IanAber/CurrentSensor/DC Sensor Documentation.odt

DC Measurement Device ModBus Layout

R/W | Register Type | Register Number | Function
W | Holding | 3 | Set Low Voltage Calibration
W | Holding | 4 | Set High Voltage Calibration
W | Multiple Holding | 5-6 | Set Low Current Calibration
W | Multiple Holding | 7-8 | Set High Current Calibration
R | Inputs | 0 | Voltage
R | Inputs | 1 | Current Low Word
R | Inputs | 2 | Current High Word
