IanAber/CurrentSensor/Core/Src/main.c

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
/* Includes ------------------------------------------------------------------*/
#include "main.h"
#include "cmsis_os.h"
#include "can.h"
#include "iwdg.h"
#include "spi.h"
#include "usart.h"
#include "usb.h"
#include "gpio.h"

/* USER CODE BEGIN Includes */
#include "MCP3462.h"
/* USER CODE END Includes */


/* USER CODE BEGIN PV */
modbusHandler_t ModbusH;
ModbusDATA_t ModbusDATA;

/* USER CODE END PV */

void SystemClock_Config(void);
void MX_FREERTOS_Init(void);
/**
  * @brief  The application entry point.
  * @retval int
  */
int main(void)
{
  /* MCU Configuration--------------------------------------------------------*/

  /* Reset of all peripherals, Initializes the Flash interface and the Systick. */
  HAL_Init();

  /* Configure the system clock */
  SystemClock_Config();

  /* Initialize all configured peripherals */
  MX_GPIO_Init();
  MX_CAN_Init();
  MX_SPI1_Init();
  MX_USART1_UART_Init();
  MX_USB_PCD_Init();
  MX_IWDG_Init();
  /* USER CODE BEGIN 2 */

  /* Get the slope and offset parameters from Flash memory */
  LoadCalibrationData();

  /* flash LEDs to show startup */
  for ( int i = 0; i < 5; i++) {
	  HAL_GPIO_WritePin(GREEN_LED_GPIO_Port, GREEN_LED_Pin, GPIO_PIN_SET);
	  HAL_Delay(100);
	  HAL_GPIO_WritePin(RED_LED_GPIO_Port, RED_LED_Pin, GPIO_PIN_SET);
	  HAL_Delay(100);
	  HAL_GPIO_WritePin(GREEN_LED_GPIO_Port, GREEN_LED_Pin, GPIO_PIN_RESET);
	  HAL_Delay(100);
	  HAL_GPIO_WritePin(RED_LED_GPIO_Port, RED_LED_Pin, GPIO_PIN_RESET);
	  HAL_Delay(100);
  }


  /* USER CODE END 2 */

  /* Init scheduler */
  osKernelInitialize();

  /* Call init function for freertos objects (in freertos.c) */
  MX_FREERTOS_Init();

  /* Start scheduler */
  osKernelStart();

  /* We should never get here as control is now taken by the scheduler */
  /* Infinite loop */
  /* USER CODE BEGIN WHILE */
  while (1)
  {
	  HAL_GPIO_WritePin(RED_LED_GPIO_Port, RED_LED_Pin, GPIO_PIN_SET);
	  HAL_Delay(200);
	  HAL_GPIO_WritePin(RED_LED_GPIO_Port, RED_LED_Pin, GPIO_PIN_RESET);
	  HAL_Delay(100);
    /* USER CODE END WHILE */

    /* USER CODE BEGIN 3 */
  }
  /* USER CODE END 3 */
}

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
