IanAber/CurrentSensor/CurrentSensorV3.ioc

Mcu.UserName=STM32F072C8Tx
PA0.Signal=GPIO_Input
PA1.Signal=GPIO_Input
PA10.GPIO_Label=RS485_RX
PA10.Signal=USART1_RX
PA11.Signal=USB_DM
PA12.Signal=USB_DP
PA13.Signal=SYS_SWDIO
PA14.Signal=SYS_SWCLK
PA15.Signal=GPIO_Input
PA2.Signal=GPIO_Input
PA3.GPIO_Label=ADC_INT
PA3.Signal=GPXTI3
PA4.GPIO_Label=ADC_CS
PA4.Signal=GPIO_Output
PA5.Signal=SPI1_SCK
PA6.Signal=SPI1_MISO
PA7.Signal=SPI1_MOSI
PA8.GPIO_Label=RS485_TXEN
PA8.Signal=GPIO_Output
PA9.GPIO_Label=RS485_TX
PA9.Signal=USART1_TX
PB0.GPIO_Label=RED_LED
PB0.Signal=GPIO_Output
PB1.GPIO_Label=GREEN_LED
PB1.Signal=GPIO_Output
PB10.Signal=GPIO_Input
PB11.Signal=GPIO_Input
PB12.Signal=GPIO_Input
PB13.Signal=GPIO_Input
PB14.Signal=GPIO_Input
PB15.Signal=GPIO_Input
PB2.GPIO_Label=ADDR0
PB2.Signal=GPIO_Input
PB3.GPIO_Label=ADDR1
PB3.Signal=GPIO_Input
PB4.GPIO_Label=ADDR2
PB4.Signal=GPIO_Input
PB5.GPIO_Label=Debug
PB5.Signal=GPIO_Output
PB6.GPIO_Label=CAN250
PB6.Signal=GPIO_Input
PB7.GPIO_Label=MODBUS9600
PB7.Signal=GPIO_Input
PB8.Signal=CAN_RX
PB9.Signal=CAN_TX
PC13.Signal=GPIO_Input
PC14-OSC32_IN.Signal=GPIO_Input
PC15-OSC32_OUT.Signal=GPIO_Input
PF0-OSC_IN.Signal=RCC_OSC_IN
PF1-OSC_OUT.Signal=RCC_OSC_OUT
