IanAber/CurrentSensor/Core/Inc/main.h

#define ADC_INT_Pin GPIO_PIN_3
#define ADC_INT_GPIO_Port GPIOA
#define ADC_INT_EXTI_IRQn EXTI2_3_IRQn
#define ADC_CS_Pin GPIO_PIN_4
#define ADC_CS_GPIO_Port GPIOA
#define RED_LED_Pin GPIO_PIN_0
#define RED_LED_GPIO_Port GPIOB
#define GREEN_LED_Pin GPIO_PIN_1
#define GREEN_LED_GPIO_Port GPIOB
#define ADDR0_Pin GPIO_PIN_2
#define ADDR0_GPIO_Port GPIOB
#define RS485_TXEN_Pin GPIO_PIN_8
#define RS485_TXEN_GPIO_Port GPIOA
#define RS485_TX_Pin GPIO_PIN_9
#define RS485_TX_GPIO_Port GPIOA
#define RS485_RX_Pin GPIO_PIN_10
#define RS485_RX_GPIO_Port GPIOA
#define ADDR1_Pin GPIO_PIN_3
#define ADDR1_GPIO_Port GPIOB
#define ADDR2_Pin GPIO_PIN_4
#define ADDR2_GPIO_Port GPIOB
#define Debug_Pin GPIO_PIN_5
#define Debug_GPIO_Port GPIOB
#define CAN250_Pin GPIO_PIN_6
#define CAN250_GPIO_Port GPIOB
#define MODBUS9600_Pin GPIO_PIN_7
#define MODBUS9600_GPIO_Port GPIOB
#define ModbusTimeoutMs	100
#define ModbusSlaveID	10
#define NumCoils		8
#define NumDiscreteInputs 4
#define NumInputs 10
#define NumHoldingRegisters 8
#define RegisterBytes ((NumCoils + 7) / 8) + ((NumDiscreteInputs + 7) / 8) + (NumInputs * 2) + (NumHoldingRegisters * 2)
#define DiscreteStart (NumCoils + 7) / 8
#define InputRegistersStart DiscreteStart + ((NumDiscreteInputs + 7) / 8)
#define HoldingRegistersStart InputRegistersStart + (NumInputs * 2)
#define VoltageRegister	0
#define CurrentLow			1
#define CurrentHigh		2
#define PowerLow			3
#define PowerHigh			4
#define EnergyLow			5
#define EnergyHigh			6
#define Frequency			7
#define PowerFactor		8
#define Alarm					9
#define AlarmThreshold	1
#define SlaveAddress		1
