IanAber/CurrentSensor/Core/Src/can.c

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
/* Includes ------------------------------------------------------------------*/
#include "can.h"

/* USER CODE BEGIN 0 */

extern osTimerId_t RedLedOffTimerHandle;

/* USER CODE END 0 */

CAN_HandleTypeDef hcan;

/* CAN init function */
void MX_CAN_Init(void)
{

  /* USER CODE BEGIN CAN_Init 1 */
	uint32_t PRESCALER = 8;		// 500 kbps
	if (!HAL_GPIO_ReadPin(CAN250_GPIO_Port, ADDR1_Pin)) {
		PRESCALER = 16;		// 250kbps
	}
  /* USER CODE END CAN_Init 1 */
  hcan.Instance = CAN;
  hcan.Init.Prescaler = PRESCALER;
  hcan.Init.Mode = CAN_MODE_NORMAL;
  hcan.Init.SyncJumpWidth = CAN_SJW_1TQ;
  hcan.Init.TimeSeg1 = CAN_BS1_4TQ;
  hcan.Init.TimeSeg2 = CAN_BS2_7TQ;
  hcan.Init.TimeTriggeredMode = DISABLE;
  hcan.Init.AutoBusOff = ENABLE;
  hcan.Init.AutoWakeUp = ENABLE;
  hcan.Init.AutoRetransmission = DISABLE;
  hcan.Init.ReceiveFifoLocked = DISABLE;
  hcan.Init.TransmitFifoPriority = DISABLE;
  if (HAL_CAN_Init(&hcan) != HAL_OK)
  {
    Error_Handler();
  }
}

void HAL_CAN_MspInit(CAN_HandleTypeDef* canHandle)
{

  GPIO_InitTypeDef GPIO_InitStruct = {0};
  if(canHandle->Instance==CAN)
  {
    /* CAN clock enable */
    __HAL_RCC_CAN1_CLK_ENABLE();

    __HAL_RCC_GPIOB_CLK_ENABLE();
    /**CAN GPIO Configuration
    PB8     ------> CAN_RX
    PB9     ------> CAN_TX
    */
    GPIO_InitStruct.Pin = GPIO_PIN_8|GPIO_PIN_9;
    GPIO_InitStruct.Mode = GPIO_MODE_AF_PP;
    GPIO_InitStruct.Pull = GPIO_NOPULL;
    GPIO_InitStruct.Speed = GPIO_SPEED_FREQ_HIGH;
    GPIO_InitStruct.Alternate = GPIO_AF4_CAN;
    HAL_GPIO_Init(GPIOB, &GPIO_InitStruct);

    /* CAN interrupt Init */
    HAL_NVIC_SetPriority(CEC_CAN_IRQn, 3, 0);
    HAL_NVIC_EnableIRQ(CEC_CAN_IRQn);
  }
}

void HAL_CAN_MspDeInit(CAN_HandleTypeDef* canHandle)
{

  if(canHandle->Instance==CAN)
  {
    /* Peripheral clock disable */
    __HAL_RCC_CAN1_CLK_DISABLE();

    /**CAN GPIO Configuration
    PB8     ------> CAN_RX
    PB9     ------> CAN_TX
    */
    HAL_GPIO_DeInit(GPIOB, GPIO_PIN_8|GPIO_PIN_9);

    /* CAN interrupt Deinit */
    HAL_NVIC_DisableIRQ(CEC_CAN_IRQn);
  }
}

/* USER CODE BEGIN 1 */
CAN_RxHeaderTypeDef   RxHeader;
uint8_t               RxData[8];

extern osMessageQueueId_t RelayOuputQueueHandle;

// Receiving CAN frames
void HAL_CAN_RxFifo0MsgPendingCallback(CAN_HandleTypeDef *hcan) {
	if (HAL_CAN_GetRxMessage(hcan, CAN_RX_FIFO0, &RxHeader, RxData) != HAL_OK) {
		/* Reception Error */
		HAL_GPIO_WritePin(RED_LED_GPIO_Port, RED_LED_Pin, GPIO_PIN_SET);
		xTimerStart(RedLedOffTimerHandle, 200);
		return;
	}
	// TODO - Handle incoming CAN frames
}

void StartCANReception (CAN_HandleTypeDef hcan) {

		/*##- Configure the CAN Filter ###########################################*/
	/* Set the filter to allow only the calibration frames through for this devices address */
		CAN_FilterTypeDef  sFilterConfig;

		sFilterConfig.FilterBank = 0;
		sFilterConfig.FilterMode = CAN_FILTERMODE_IDMASK;
		sFilterConfig.FilterScale = CAN_FILTERSCALE_32BIT;
		sFilterConfig.FilterIdHigh = 0x0000;
		sFilterConfig.FilterIdLow = 0x0000;
		sFilterConfig.FilterMaskIdHigh = 0x0000;
		sFilterConfig.FilterMaskIdLow = 0x0000;
		sFilterConfig.FilterFIFOAssignment = CAN_RX_FIFO0;
		sFilterConfig.FilterActivation = ENABLE;
		sFilterConfig.SlaveStartFilterBank = 14;

		if (HAL_CAN_ConfigFilter(&hcan, &sFilterConfig) != HAL_OK) {
			/* Filter configuration Error */
			Error_Handler();
		}

		if (HAL_CAN_Start(&hcan) != HAL_OK) {
			/* Failed to start the CAN interface */
			Error_Handler();
		}

		if (HAL_CAN_ActivateNotification(&hcan, CAN_IT_RX_FIFO0_MSG_PENDING) != HAL_OK)
		{
			/* Notification Error */
			Error_Handler();
		}
}

/* USER CODE END 1 */
