IanAber/CurrentSensor/Core/Src/FLASH_PAGE_F1.c

/**
  ***************************************************************************************************************
  ***************************************************************************************************************
  ***************************************************************************************************************
  File:	      FLASH_PAGE_F1.c
  Modifier:   ControllersTech.com
  Updated:    27th MAY 2021
  ***************************************************************************************************************
  Copyright (C) 2017 ControllersTech.com
  This is a free software under the GNU license, you can redistribute it and/or modify it under the terms
  of the GNU General Public License version 3 as published by the Free Software Foundation.
  This software library is shared with public for educational purposes, without WARRANTY and Author is not liable for any damages caused directly
  or indirectly by this software, read more about this on the GNU General Public License.
  ***************************************************************************************************************
*/

#include "FLASH_PAGE_F1.h"
#include "string.h"
#include "stdio.h"


/* STM32F072 have 128K  (Page 0 to Page 63) of 2 KB each. This makes up 128 KB Flash Memory
 * Some STM32F103C8 have 64 KB FLASH Memory, so I guess they have Page 0 to Page 31 only.
 */

/* FLASH_PAGE_SIZE should be able to get the size of the Page according to the controller */
static uint32_t GetPage(uint32_t Address)
{
  for (int indx=0; indx<128; indx++)
  {
	  if((Address < (0x08000000 + (FLASH_PAGE_SIZE *(indx+1))) ) && (Address >= (0x08000000 + FLASH_PAGE_SIZE*indx)))
	  {
		  return (0x08000000 + FLASH_PAGE_SIZE*indx);
	  }
  }

  return 0;
}


uint8_t bytes_temp[4];


void float2Bytes(uint8_t * ftoa_bytes_temp,float float_variable)
{
    union {
      float a;
      uint8_t bytes[4];
    } thing;

    thing.a = float_variable;

    for (uint8_t i = 0; i < 4; i++) {
      ftoa_bytes_temp[i] = thing.bytes[i];
    }

}

float Bytes2float(uint8_t * ftoa_bytes_temp)
{
    union {
      float a;
      uint8_t bytes[4];
    } thing;

    for (uint8_t i = 0; i < 4; i++) {
    	thing.bytes[i] = ftoa_bytes_temp[i];
    }

   float float_variable =  thing.a;
   return float_variable;
}

uint32_t Flash_Write_Data (uint32_t StartPageAddress, uint32_t *Data, uint16_t numberofwords)
{

	static FLASH_EraseInitTypeDef EraseInitStruct;
	uint32_t PAGEError;
	int sofar=0;

	  /* Unlock the Flash to enable the flash control register access *************/
	   HAL_FLASH_Unlock();

	   /* Erase the user Flash area*/

	  uint32_t StartPage = GetPage(StartPageAddress);
	  uint32_t EndPageAdress = StartPageAddress + numberofwords*4;
	  uint32_t EndPage = GetPage(EndPageAdress);

	   /* Fill EraseInit structure*/
	   EraseInitStruct.TypeErase   = FLASH_TYPEERASE_PAGES;
	   EraseInitStruct.PageAddress = StartPage;
	   EraseInitStruct.NbPages     = ((EndPage - StartPage)/FLASH_PAGE_SIZE) +1;

	   if (HAL_FLASHEx_Erase(&EraseInitStruct, &PAGEError) != HAL_OK)
	   {
	     /*Error occurred while page erase.*/
		  return HAL_FLASH_GetError ();
	   }

	   /* Program the user Flash area word by word*/

	   while (sofar<numberofwords)
	   {
	     if (HAL_FLASH_Program(FLASH_TYPEPROGRAM_WORD, StartPageAddress, Data[sofar]) == HAL_OK)
	     {
	    	 StartPageAddress += 4;  // use StartPageAddress += 2 for half word and 8 for double word
	    	 sofar++;
	     }
	     else
	     {
	       /* Error occurred while writing data in Flash memory*/
	    	 return HAL_FLASH_GetError ();
	     }
	   }

	   /* Lock the Flash to disable the flash control register access (recommended
	      to protect the FLASH memory against possible unwanted operation) *********/
	   HAL_FLASH_Lock();

	   return 0;
}


void Flash_Read_Data (uint32_t StartPageAddress, uint32_t *RxBuf, uint16_t numberofwords)
{
	while (1)
	{

		*RxBuf = *(volatile uint32_t *)StartPageAddress;
		StartPageAddress += 4;
		RxBuf++;
		if (!(numberofwords--)) break;
	}
}
void Convert_To_Str (uint32_t *Data, char *Buf)
{
	int numberofbytes = ((strlen((char *)Data)/4) + ((strlen((char *)Data) % 4) != 0)) *4;

	for (int i=0; i<numberofbytes; i++)
	{
		Buf[i] = Data[i/4]>>(8*(i%4));
	}
}


void Flash_Write_NUM (uint32_t StartSectorAddress, float Num)
{

	float2Bytes(bytes_temp, Num);

	Flash_Write_Data (StartSectorAddress, (uint32_t *)bytes_temp, 1);
}


float Flash_Read_NUM (uint32_t StartSectorAddress)
{
	uint8_t buffer[4];
	float value;

	Flash_Read_Data(StartSectorAddress, (uint32_t *)buffer, 1);
	value = Bytes2float(buffer);
	return value;
}
