IanAber/CurrentSensor/Core/Inc/InterruptHandlers.h

/*
 * InterruptHandlers.h
 *
 *  Created on: Oct 12, 2022
 *      Author: ianaber
 */

#ifndef INC_INTERRUPTHANDLERS_H_
#define INC_INTERRUPTHANDLERS_H_


#define SIGNAL_ADC_INTERRUPT	1



#endif /* INC_INTERRUPTHANDLERS_H_ */
