IanAber/CurrentSensor/(notices)

Notices in the files:
Core/Src/main.c:
Copyright (c) 2023 STMicroelectronics.
All rights reserved.
This software is licensed under terms that can be found in the LICENSE file
